SpoWT/brain-controlled-drone-flight/hardware/README.md

# Hardware

Printed parts and the parts list ([PARTS.md](PARTS.md)).

| Path | Contents |
|---|---|
| `fpv_goggles_v1.3mf` | The goggles: all 20 printed parts in one file (shells, Fresnel lens cassette, monitor carriage, camera carriers, guards and aim yokes, battery tray, electronics bridge) |
| `gear/` | Head gear the goggles mount to: `gear_connnect_headset_print_1`, `gear_c_head_2`, `g_c_vr2_print` |
| `drone_frames/` | Every drone frame version, oldest to newest (table below) |

## Drone frames

| # | Files |
|---:|---|
| 1 | `drone_frame.3mf` |
| 2 | `drone_frame_gd.stl` |
| 3 | `drone_frame_1.stl`, `drone_frame_3mf.3mf` |
| 4 | `drone_frame_gd_4.stl`, `.3mf` |
| 5 | `drone_frame_gd_5.stl` |
| 6 | `drone_frame_gd_6.stl`, `.3mf` |
| 7 | `drone_gd_5in_1.stl`, `.3mf` |
| 8 | `drone_frame_5_inch_prop.f3z` (Fusion) |
| 9 | `drone_frame_gd_7.stl`, `.3mf` |
| 10 | `drone_frame_5in_v3.f3d` (Fusion) |
| 11 | `drone_frame_5in_v3_1.stl` |
| 12 | `drone_frame_5in_v3_2.stl` (final) |

`.stl` and `.3mf` open in any slicer; `.f3d` / `.f3z` are Fusion source files.
