SpoWT/brain-controlled-drone-flight/hardware/drone_frames/drone_frame_5in_v3_2.stl

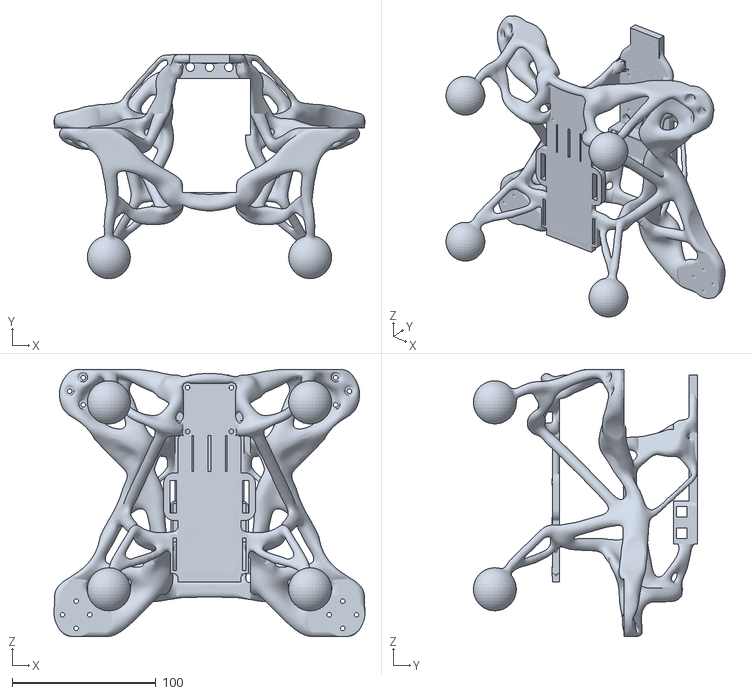
[picture p1: CAD file, 2026-10-29]
hardware/drone_frames/drone_frame_5in_v3_2.stl
216.3 x 155.9 x 185.8
