SpoWT/brain-controlled-drone-flight/hardware/fpv_goggles_v1.3mf

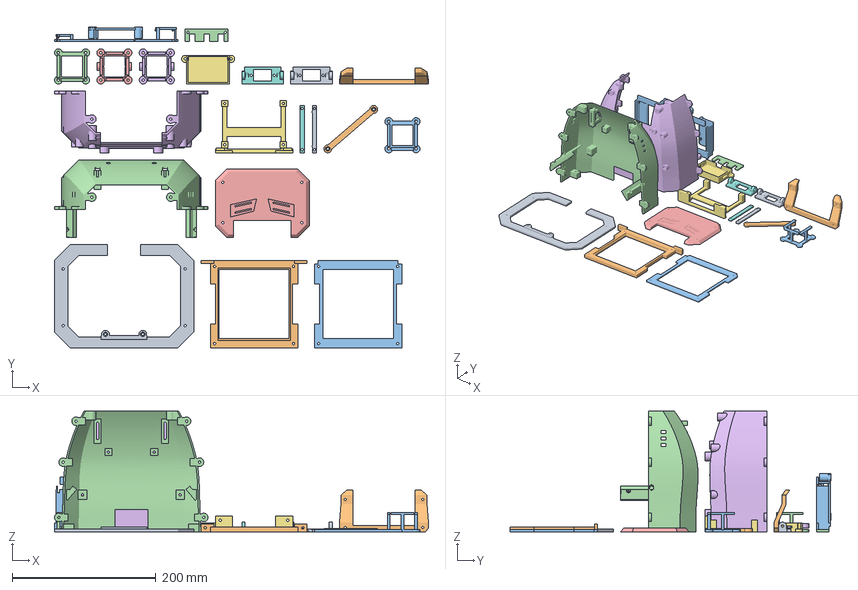
[picture p2: CAD file, 2026-10-29]
hardware/fpv_goggles_v1.3mf
521.0 x 446.9 x 168.0 mm
P14_Removable_face_foam_carrier
P03_Fresnel_cassette
P04_Fresnel_retainer
P02_Lower_shell_and_focus_rails
P07_Front_bumper
P01_Upper_shell_and_headgear_mount
P05_Monitor_focus_carriage
P06_Monitor_jaw_L
P06_Monitor_jaw_R
P10_USB_hub_retaining_bridge
P12_Camera_guard_L
P12_Camera_guard_R
P11_Camera_carrier_L
P11_Camera_carrier_R
P08_Battery_tray
P13_Camera_aim_yoke_L
P13_Camera_aim_yoke_R
P16_Removable_service_brow
P09_Electronics_bridge
P15_Rear_cable_comb
