SpoWT/brain-controlled-drone-flight/hardware/gear/gear_connnect_headset_print_1.3mf

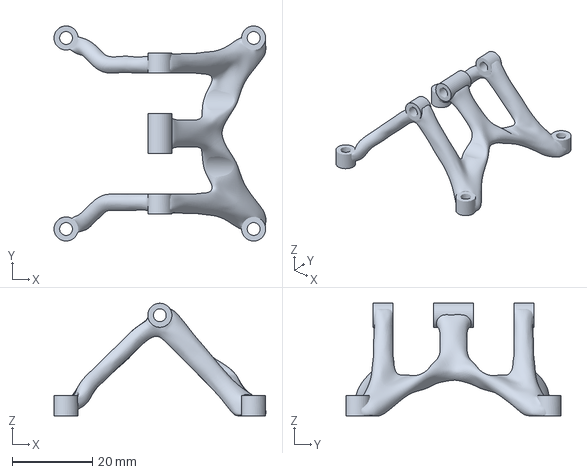
[picture p3: CAD file, 2026-10-29]
hardware/gear/gear_connnect_headset_print_1.3mf
52.7 x 53.5 x 28.0 mm
