SpoWT/brain-controlled-drone-flight/hardware/drone_frames/drone_frame_1.stl

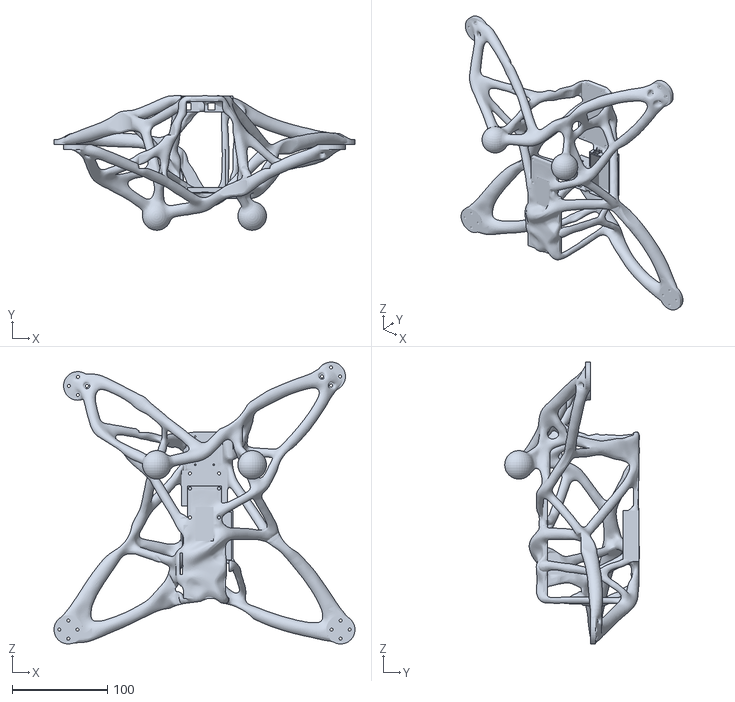
[picture p4: CAD file, 2026-10-29]
hardware/drone_frames/drone_frame_1.stl
315.5 x 141.2 x 295.5
