SpoWT/brain-controlled-drone-flight/hardware/gear/g_c_vr2_print.stl

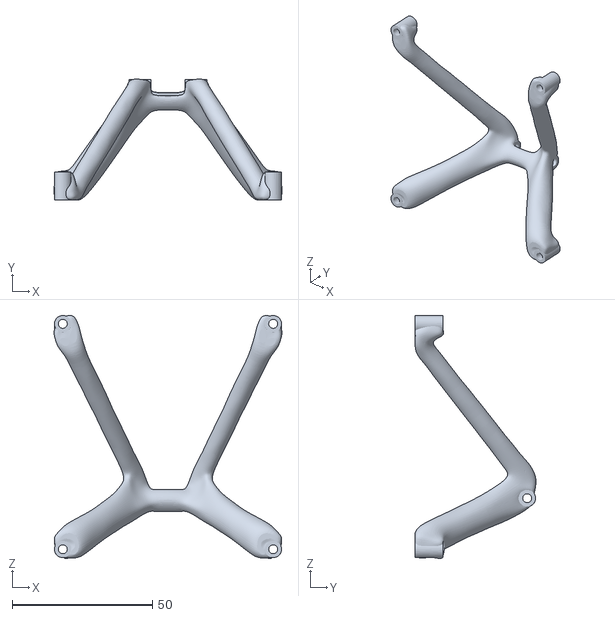
[picture p5: CAD file, 2026-10-29]
hardware/gear/g_c_vr2_print.stl
81.3 x 43.1 x 86.7
