SpoWT/brain-controlled-drone-flight/hardware/drone_frames/drone_frame_gd.stl

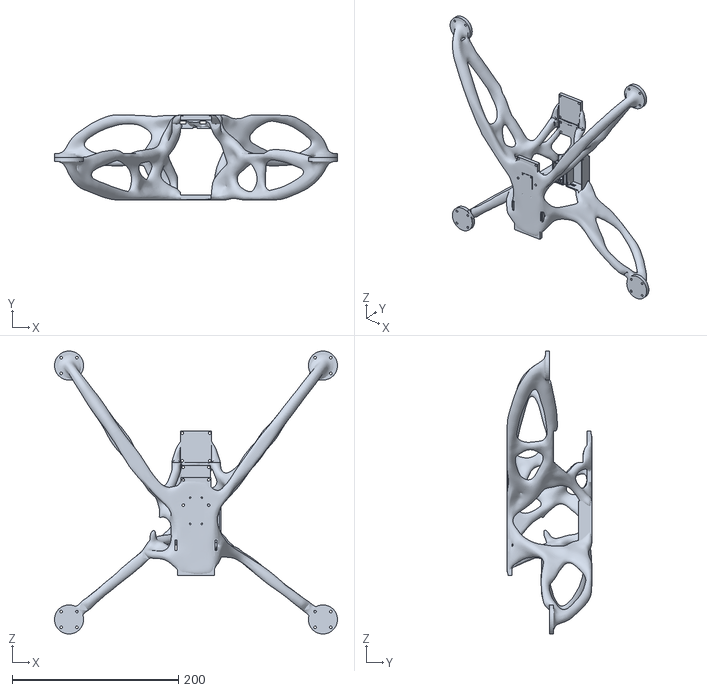
[picture p6: CAD file, 2026-10-29]
hardware/drone_frames/drone_frame_gd.stl
340.5 x 102.4 x 340.5
