SpoWT/brain-controlled-drone-flight/hardware/gear/gear_c_head_2.3mf

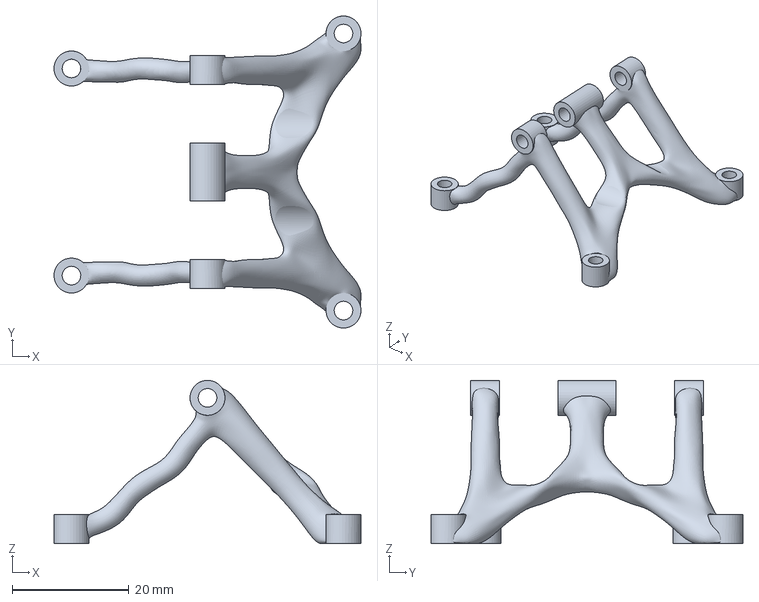
[picture p7: CAD file, 2026-10-29]
hardware/gear/gear_c_head_2.3mf
52.6 x 53.5 x 28.0 mm
