SpoWT/brain-controlled-drone-flight/hardware/drone_frames/drone_frame_gd_6.3mf

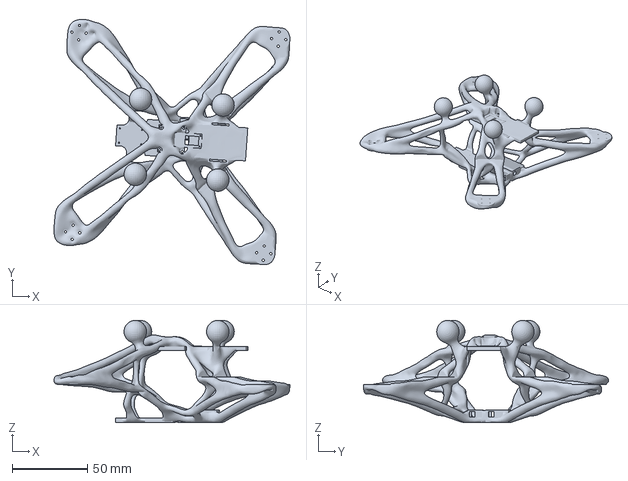
[picture p8: CAD file, 2026-10-29]
hardware/drone_frames/drone_frame_gd_6.3mf
157.2 x 163.3 x 68.1 mm
