SpoWT/brain-controlled-drone-flight/hardware/drone_frames/drone_frame_gd_4.3mf

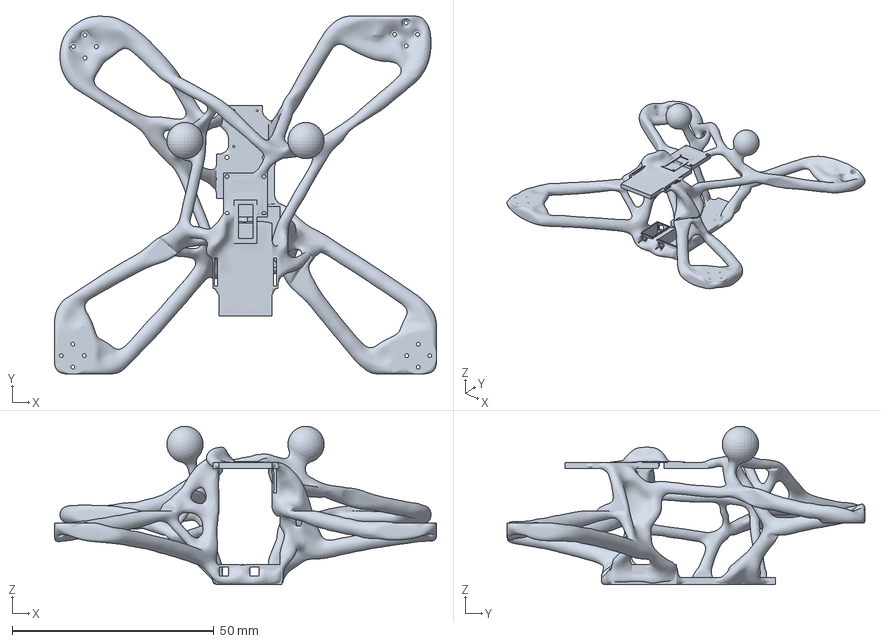
[picture p9: CAD file, 2026-10-29]
hardware/drone_frames/drone_frame_gd_4.3mf
94.8 x 88.8 x 39.3 mm
