SpoWT/brain-controlled-drone-flight/hardware/drone_frames/drone_gd_5in_1.3mf

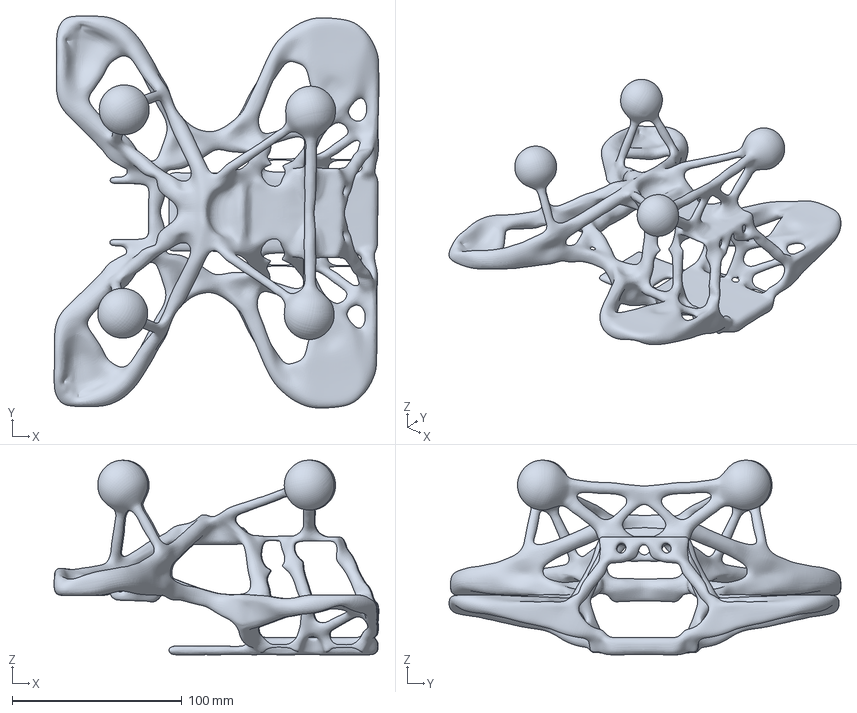
[picture p10: CAD file, 2026-10-29]
hardware/drone_frames/drone_gd_5in_1.3mf
191.5 x 231.2 x 114.8 mm
