SpoWT/brain-controlled-drone-flight/hardware/drone_frames/drone_frame_gd_7.3mf

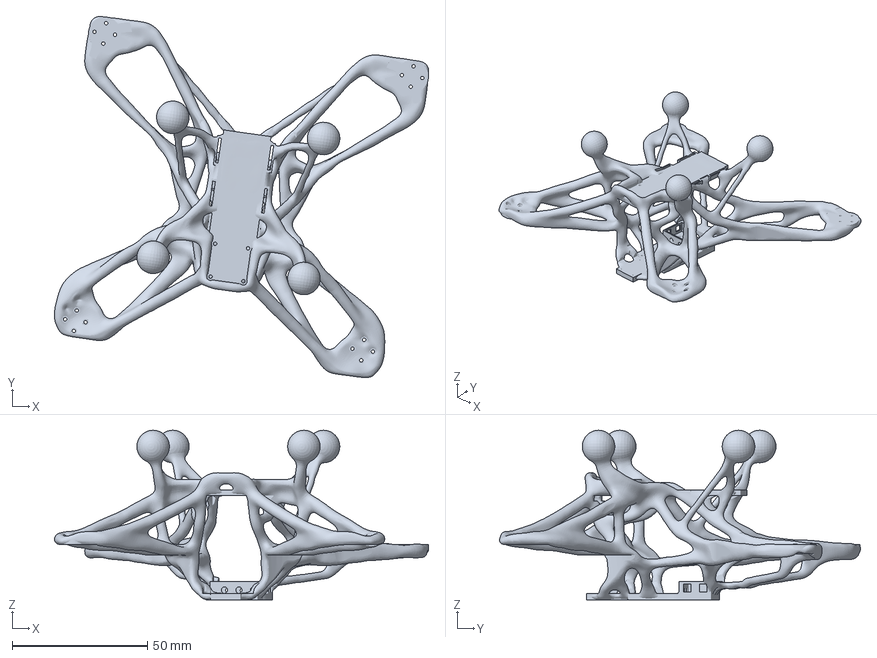
[picture p11: CAD file, 2026-10-29]
hardware/drone_frames/drone_frame_gd_7.3mf
138.1 x 133.3 x 62.6 mm
