SpoWT/brain-controlled-drone-flight/hardware/drone_frames/drone_frame_gd_5.stl

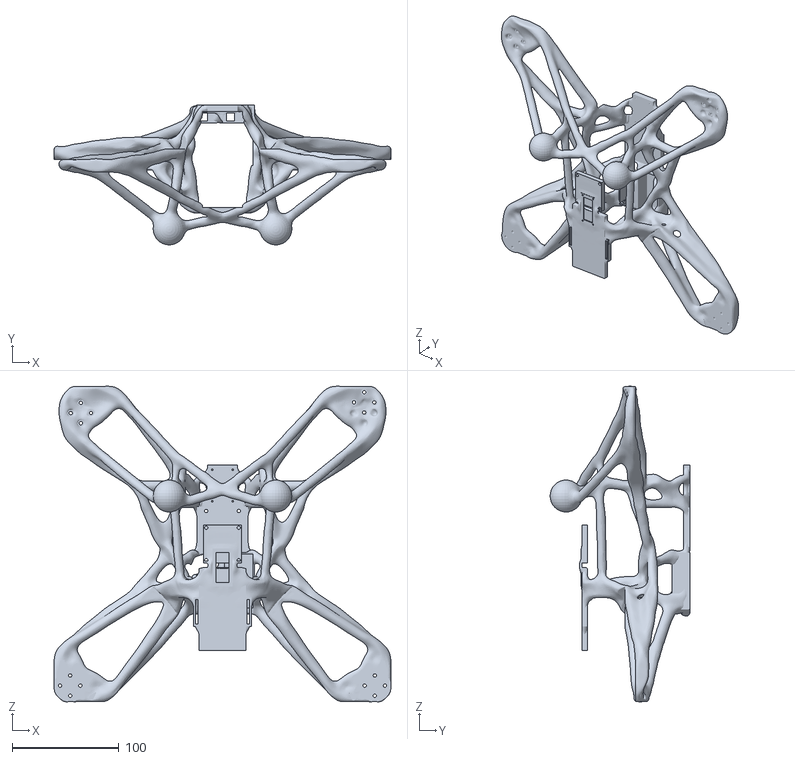
[picture p12: CAD file, 2026-10-29]
hardware/drone_frames/drone_frame_gd_5.stl
315.8 x 131.0 x 295.8
