SpoWT/brain-controlled-drone-flight/(list of files, cad)

Other CAD files:
hardware/drone_frames/drone_frame.3mf
hardware/drone_frames/drone_frame_3mf.3mf
hardware/drone_frames/drone_frame_5in_v3_1.stl
hardware/drone_frames/drone_frame_5_inch_prop.f3z
hardware/drone_frames/drone_frame_5in_v3.f3d
hardware/drone_frames/drone_frame_gd_4.stl
hardware/drone_frames/drone_frame_gd_6.stl
hardware/drone_frames/drone_frame_gd_7.stl
hardware/drone_frames/drone_gd_5in_1.stl
hardware/gear/gear_c_head_2.stl
hardware/gear/gear_connnect_headset_print_1.stl
