SpoWT/brain-controlled-drone-flight/(commit log)

2026-10-29 docs: add printed hardware and the parts list
    Every drone frame version, the head gear, the FPV goggles as one 3MF,
    and the modules used in the final build.
    [drone_frame.3mf, drone_frame_1.stl, drone_frame_3mf.3mf, drone_frame_5_inch_prop.f3z, drone_frame_5in_v3.f3d, drone_frame_5in_v3_1.stl, drone_frame_5in_v3_2.stl, drone_frame_gd.stl]
2026-10-29 fix: flight safety review fixes
    [ardupilot_flight_transport.py, assisted_flight_service.py, fake_ardupilot.py, test_ardupilot_transport.py]
2026-10-30 feat: folders, eye steering, gimbal tilt, simpler Drone App
